Villela-G/educational_bench_for_angular_aero_control_of_multirotors/docs/documentation.md

---
layout: docs
title: Documentation
---

# Documentation

This section provides all the necessary information to reproduce and understand the platform.

The documentation follows a logical workflow from system design to final assembly.

---

## Structure

1. Hardware Design  
2. Electronics  
3. Bill of Materials  
4. Assembly  

---

## Navigation

Use the sidebar to access each section directly, or follow the sequence using the navigation below.

---

<div class="nav-next">
  <a href="hardware.html">Next: Hardware Design →</a>
</div>
