Villela-G/educational_bench_for_angular_aero_control_of_multirotors/docs/assets/images/bancada.jpeg

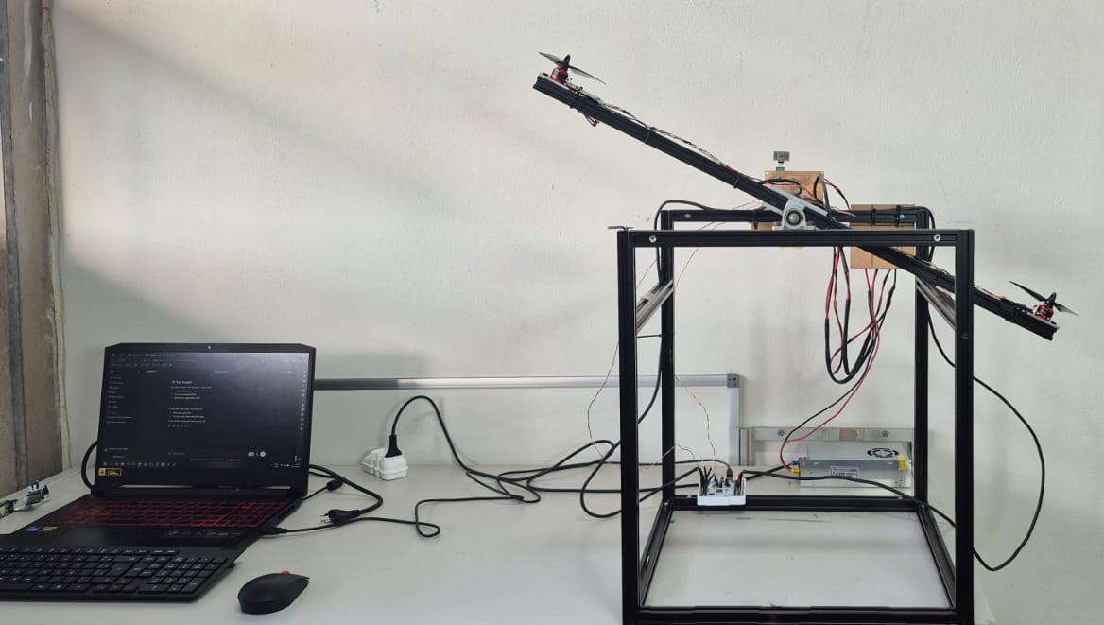
docs/assets/images/bancada.jpeg
