Villela-G/educational_bench_for_angular_aero_control_of_multirotors/docs/bom.md

---
layout: docs
title: Bill of Materials
---

# Bill of Materials

This section lists all components required to reproduce the platform, including mechanical, electronic, and structural elements.

---

## Components

<div style="overflow-x: auto; margin-top: 20px;">

<table>
<thead>
<tr>
<th>Designator</th>
<th>Component</th>
<th>Quantity</th>
<th>Material</th>
</tr>
</thead>

<tbody>

<tr><td>STM32</td><td>STM32F401RE board</td><td>1</td><td>Semiconductor</td></tr>
<tr><td>ESP32</td><td>ESP32 Wi-Fi module</td><td>1</td><td>Semiconductor</td></tr>
<tr><td>LM358</td><td>LM358 op-amp</td><td>2</td><td>Semiconductor</td></tr>
<tr><td>L7805</td><td>L7805 regulator</td><td>1</td><td>Semiconductor</td></tr>
<tr><td>L7808</td><td>L7808 regulator</td><td>1</td><td>Semiconductor</td></tr>

<tr><td>DRV5011</td><td>DRV5011 Hall sensor</td><td>4</td><td>Semiconductor</td></tr>
<tr><td>CurrentSensor</td><td>Current sensor</td><td>2</td><td>Semiconductor</td></tr>
<tr><td>DHT22</td><td>DHT22 sensor</td><td>1</td><td>Semiconductor</td></tr>
<tr><td>BMP280</td><td>BMP280 sensor</td><td>1</td><td>Semiconductor</td></tr>

<tr><td>C3300uF</td><td>3300 µF capacitor</td><td>1</td><td>Ceramic</td></tr>
<tr><td>C1uF</td><td>1 µF capacitor</td><td>2</td><td>Ceramic</td></tr>
<tr><td>C100nF</td><td>100 nF capacitor</td><td>4</td><td>Ceramic</td></tr>
<tr><td>C102nF</td><td>102 nF capacitor</td><td>2</td><td>Ceramic</td></tr>
<tr><td>C22nF</td><td>22 nF capacitor</td><td>5</td><td>Ceramic</td></tr>

<tr><td>R33k</td><td>33 kΩ resistor</td><td>2</td><td>Ceramic</td></tr>
<tr><td>R10k</td><td>10 kΩ resistor</td><td>3</td><td>Ceramic</td></tr>

<tr><td>KRE2V</td><td>KRE 2V connector</td><td>7</td><td>Metal</td></tr>
<tr><td>KRE3V</td><td>KRE 3V connector</td><td>3</td><td>Metal</td></tr>
<tr><td>KRV2V</td><td>KRV 2V connector</td><td>2</td><td>Metal</td></tr>

<tr><td>BananaBlackMale</td><td>Banana connector (black male)</td><td>1</td><td>Metal</td></tr>
<tr><td>BananaRedMale</td><td>Banana connector (red male)</td><td>1</td><td>Metal</td></tr>
<tr><td>BananaBlackFemale</td><td>Banana connector (black female)</td><td>1</td><td>Metal</td></tr>
<tr><td>BananaRedFemale</td><td>Banana connector (red female)</td><td>1</td><td>Metal</td></tr>

<tr><td>XT60Male</td><td>XT60 connector (male)</td><td>1</td><td>Polymer</td></tr>
<tr><td>XT60Female</td><td>XT60 connector (female)</td><td>1</td><td>Polymer</td></tr>

<tr><td>Motor2207</td><td>Brushless motor 2207 2388KV</td><td>1</td><td>Composite</td></tr>
<tr><td>ESC12A</td><td>BLHeli ESC 12A</td><td>1</td><td>Semiconductor</td></tr>
<tr><td>Prop5140</td><td>5140 propeller</td><td>1</td><td>Polymer</td></tr>

<tr><td>Profile500mm</td><td>Aluminum profile 20×20 (500 mm)</td><td>4</td><td>Metal</td></tr>
<tr><td>Profile400mm</td><td>Aluminum profile 20×20 (400 mm)</td><td>10</td><td>Metal</td></tr>

<tr><td>Shaft8mm</td><td>Stainless steel shaft (8 mm)</td><td>1</td><td>Metal</td></tr>
<tr><td>Bearing</td><td>Bearing KP08</td><td>1</td><td>Metal</td></tr>

<tr><td>MotorMounts</td><td>Motor mounts (custom)</td><td>2</td><td>Metal</td></tr>
<tr><td>PillowBlock</td><td>Pillow block (custom)</td><td>1</td><td>Metal</td></tr>

<tr><td>UniversalConnector20</td><td>Connector for 20 mm T-slot</td><td>16</td><td>Metal</td></tr>

<tr><td>M5x12</td><td>M5 × 12 mm screw</td><td>12</td><td>Metal</td></tr>
<tr><td>M5x14.5</td><td>M5 × 14.5 mm screw</td><td>4</td><td>Metal</td></tr>
<tr><td>M4x12</td><td>M4 × 12 mm screw</td><td>7</td><td>Metal</td></tr>
<tr><td>M3x10</td><td>M3 × 10 mm screw</td><td>4</td><td>Metal</td></tr>

<tr><td>HammerNutM5</td><td>M5 hammer nut</td><td>16</td><td>Metal</td></tr>

<tr><td>PrecisionPot</td><td>Precision potentiometer</td><td>1</td><td>Semiconductor</td></tr>
<tr><td>Potentiometer</td><td>Potentiometer</td><td>1</td><td>Semiconductor</td></tr>

<tr><td>Switch</td><td>Switch</td><td>1</td><td>Non-specific</td></tr>
<tr><td>KCD6</td><td>KCD6 switch</td><td>1</td><td>Non-specific</td></tr>

<tr><td>HeatSink</td><td>Heat sink</td><td>2</td><td>Metal</td></tr>

<tr><td>PCBBase</td><td>Phenolic board (100 × 100 mm)</td><td>4</td><td>Composite</td></tr>

</tbody>
</table>

</div>

---

<div style="display: flex; justify-content: space-between; margin-top: 60px;">
  <a href="electronics.html">← Previous: Electronics</a>
  <a href="assembly.html">Next: Assembly →</a>
</div>
