Villela-G/educational_bench_for_angular_aero_control_of_multirotors/docs/assembly.md

---
layout: docs
title: Assembly
---

# Assembly Instructions

## Pre-assembly Modifications

**Important:** The following modifications must be completed before assembly.

### Aluminum profiles
- Eight aluminum profiles (400 mm) must be drilled at both ends  
- Two holes per profile (one at each extremity)  
- Hole diameter: 6 mm  
- Maintain a consistent distance *x* from the ends for all profiles  

### Central pillow block
- All mounting holes must be threaded for M4 screws  

---

## Part 1 — Preparation of Aluminum Profiles

### Materials
- 8 × Aluminum profiles (400 mm)  
- 16 × Universal connectors  

### Procedure

1. Insert the connector nut into the T-slot  
   
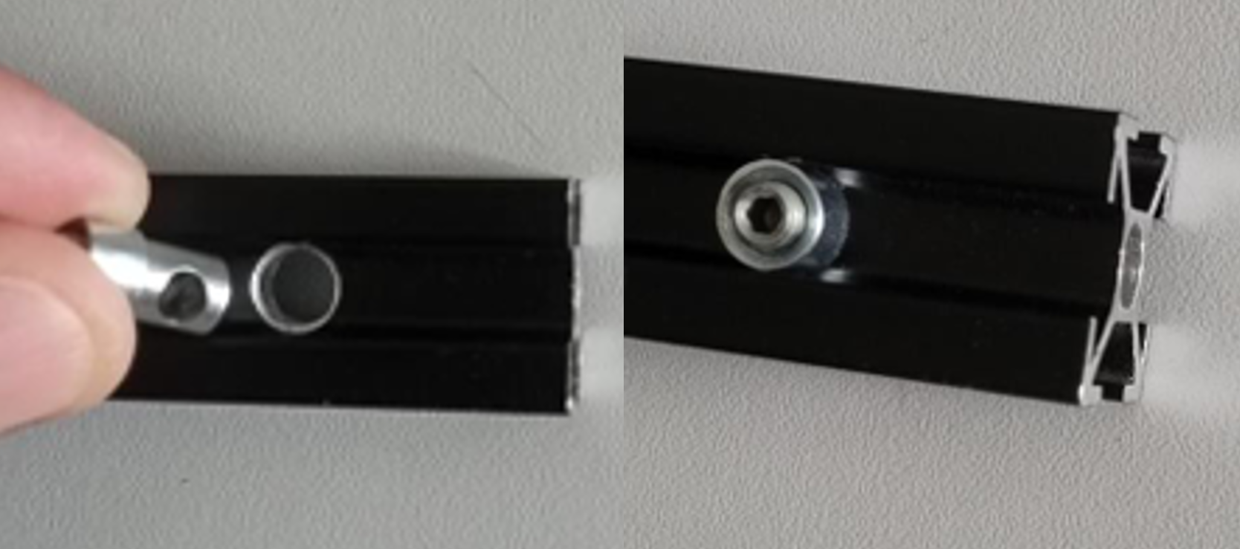
[picture p3: docs/assets/images/assembly/1.1.png]
   

2. Insert the connector screw, keeping it perpendicular  

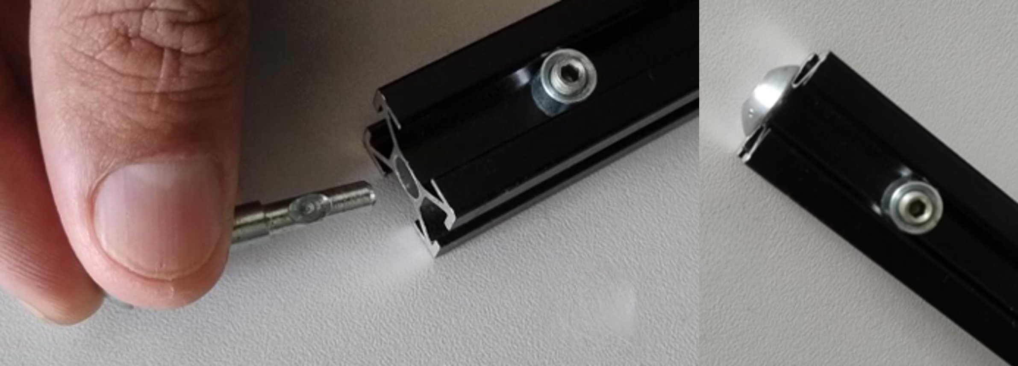
[picture p4: docs/assets/images/assembly/1.2.png]
   

3. Tighten using an Allen key  

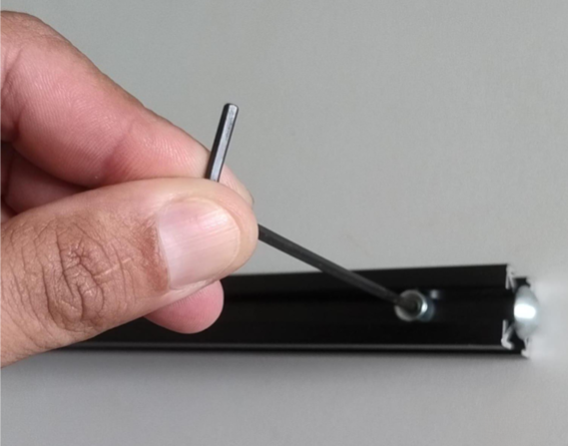
[picture p5: docs/assets/images/assembly/1.3.png]
   

4. Repeat for the opposite end and all profiles  

5. Final prepared profile:  

   

---

## Part 2 — Base Structure Assembly

### Materials
- 4 × Aluminum profiles (500 mm)  
- 8 × Aluminum profiles (400 mm)  

### Procedure

1. Arrange profiles perpendicularly  

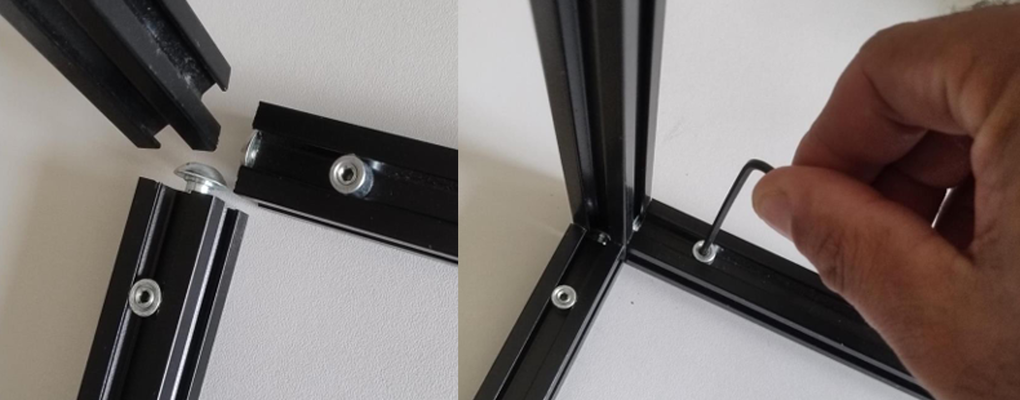
[picture p6: docs/assets/images/assembly/2.1.png]
   

2. Tighten all connections  

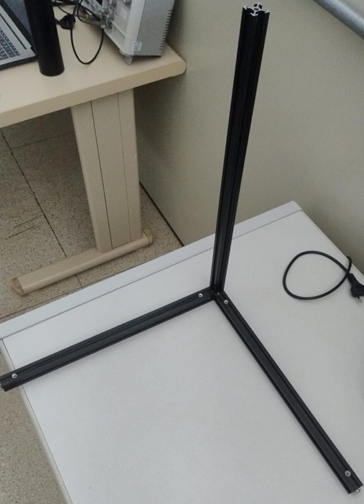
[picture p7: docs/assets/images/assembly/2.2.png]
   

3. Assemble two identical frames  

4. Join both frames into a rectangular base  

5. Fully tighten all fasteners  

   

6. Install upper profiles as end stops (~22.5 cm height)  

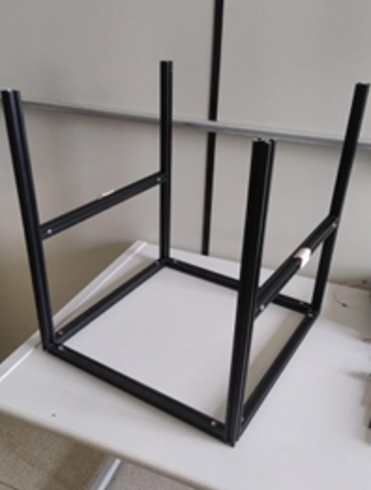
[picture p8: docs/assets/images/assembly/2.4.png]
   

7. Install shaft support profiles  

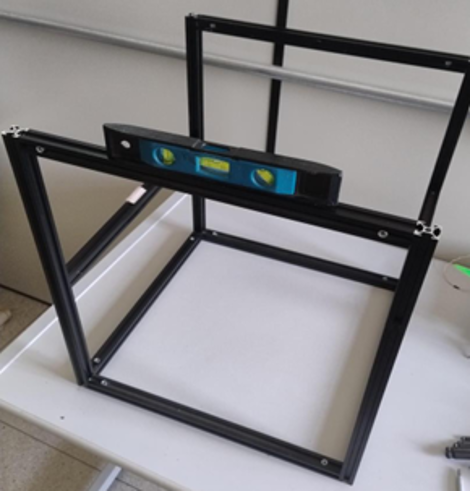
[picture p9: docs/assets/images/assembly/2.5.png]
   

8. Verify alignment and leveling  

   

---

## Part 3 — Rotational Axis and Actuation

### Materials
- 2 × Aluminum profiles (400 mm)  
- 1 × Steel shaft (8 mm × 450 mm)  
- 1 × Shaft coupler  
- 3 × Pillow block components  
- 2 × Bearing supports  
- 2 × Motor mounts  
- Fasteners (M3, M4, M5 + hammer nuts)  

### Procedure

1. Insert shaft into central pillow block  

2. Fix using M4 screws (2 top, 1 bottom)  

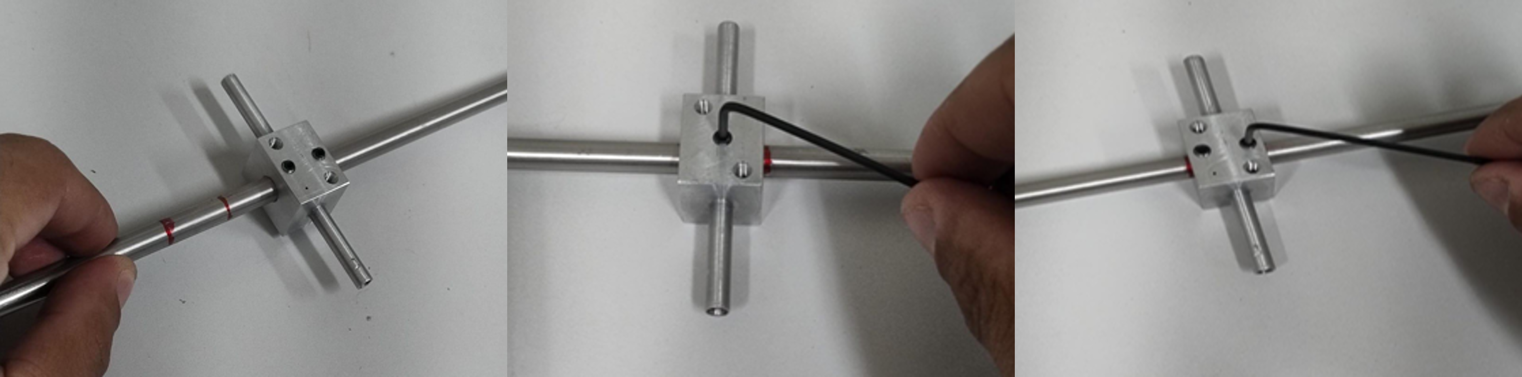
[picture p10: docs/assets/images/assembly/3.1.png]
   

3. Attach locking components  

     
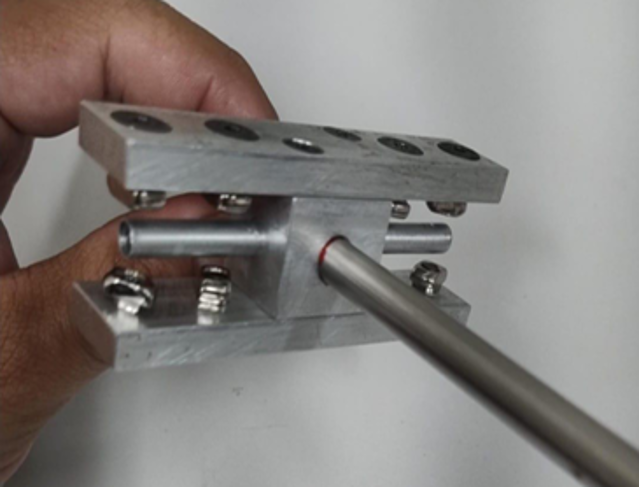
[picture p11: docs/assets/images/assembly/3.3.png]
   

4. Attach aluminum arms  

   

5. Install bearing supports and set spacing  

6. Attach shaft coupler  

   

7. Fix shaft assembly to structure  

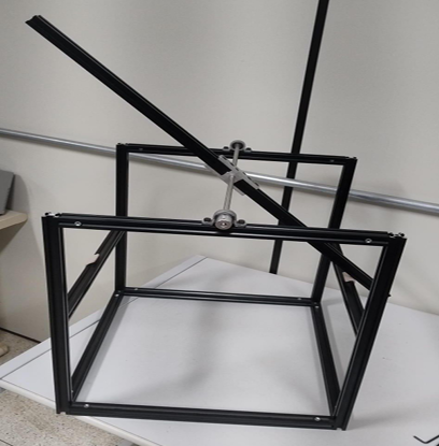
[picture p12: docs/assets/images/assembly/3.7.png]
   

8. Mount motors  

   

9. Attach motors to arms  

   

---

## Safety Notes

- Ensure all fasteners are fully tightened before operation  
- Verify structural alignment before powering the system  
- Keep clear of rotating propellers during testing  
- Use appropriate power supply and wiring insulation  

---

<div style="display: flex; justify-content: space-between; margin-top: 60px;">
  <a href="bom.html">← Previous: Bill of Materials</a>
</div>
