Villela-G/educational_bench_for_angular_aero_control_of_multirotors/docs/assets/images/assembly/3.5.png

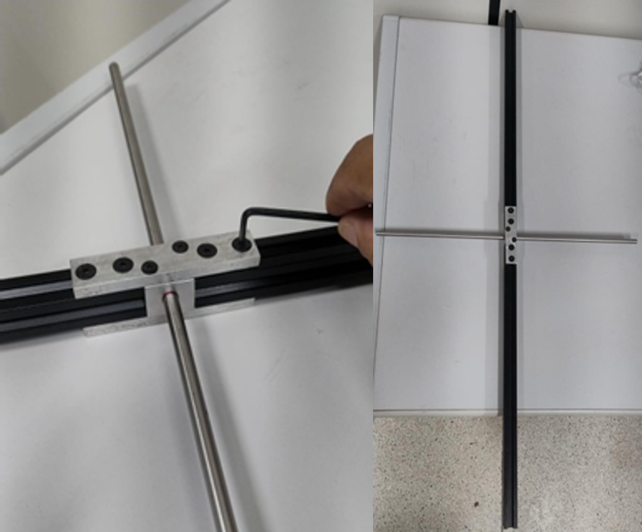
docs/assets/images/assembly/3.5.png
