Villela-G/educational_bench_for_angular_aero_control_of_multirotors/bancada_tcc_controle/Core/Src/main.c

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
/* Includes ------------------------------------------------------------------*/
#include "main.h"

/* USER CODE BEGIN Includes */
#include <stdio.h>
/* USER CODE END Includes */

/* USER CODE BEGIN PD */
#define MOTOR_RESET_CONDITION 0
#define MOTOR_IDLE_CONDITION 200
#define MOTOR_HOVER_CONDITION 1000//250
#define MOTOR_MAX_CONTROL 1800

#define KP 1.50f
#define KI 0.001f
#define KD 0.03f

#define IERR_MAX 1000.0f
#define IERR_MIN -1000.0f

#define D_FILTER_ALPHA 0.7f

//#define angle_inclination 0.619770239f
//#define angle_bias 1.187841465f

#define angle_inclination  18.15405//2.138189f
#define angle_bias 27.8726//5431.43f

#define STEP_LEFT_PWM 0
#define STEP_RIGHT_PWM_START 200U
#define STEP_RIGHT_PWM_INCREMENT 200U
#define STEP_RIGHT_PWM_LAST 1800U
#define STEP_SAMPLE_COUNT 1000U
#define STEP_COUNT (((STEP_RIGHT_PWM_LAST - STEP_RIGHT_PWM_START) / STEP_RIGHT_PWM_INCREMENT) + 1U)

/* USER CODE END PD */

ADC_HandleTypeDef hadc1;

TIM_HandleTypeDef htim2;
TIM_HandleTypeDef htim3;
TIM_HandleTypeDef htim4;

UART_HandleTypeDef huart2;
DMA_HandleTypeDef hdma_usart2_tx;

/* USER CODE BEGIN PV */
volatile uint8_t flag_user = 0;
uint8_t pData[2];

void HAL_GPIO_EXTI_Callback(uint16_t GPIO_Pin)
{
	if(GPIO_Pin == B1_Pin)
	{
		flag_user = 1;
	}
}

void blink_led(int repetitions)
{
	for(int i=0; i< repetitions; i++)
	{
	  HAL_GPIO_TogglePin(LD2_GPIO_Port, LD2_Pin);
	  HAL_Delay(20);
	}
}
void wait_user()
{
	while(!flag_user)
	{
		HAL_Delay(10);
	}
	flag_user = 0;
}

volatile uint8_t dataready = 0;
volatile uint32_t angle_in_bits = 0;
void HAL_ADC_ConvCpltCallback(ADC_HandleTypeDef* hadc)
{
    if(hadc->Instance == ADC1)
    {
        angle_in_bits = HAL_ADC_GetValue(hadc);
        dataready = 1U;
    }
}

uint32_t clip(int16_t action, uint16_t min, uint16_t max)
{
	if(action < min) action = min;
	if(action > max) action = max;
	return (uint32_t)action;
}


void PWM_setCombinedValue(TIM_HandleTypeDef* htim, int16_t left_actionx10, int16_t right_actionx10)
{//x20 não x10
	uint32_t norm_U_dir = clip(right_actionx10, 0, 2000);
	uint32_t norm_U_esq = clip(left_actionx10, 0, 2000);
	norm_U_dir = 2000+norm_U_dir;
	norm_U_esq = 2000+norm_U_esq;
	htim->Instance->CCR3 = norm_U_esq;
	htim->Instance->CCR1 = norm_U_dir;
	//__HAL_TIM_SET_COMPARE(&htim2, TIM_CHANNEL_1, norm_U_esq);
	//__HAL_TIM_SET_COMPARE(&htim2, TIM_CHANNEL_3, norm_U_dir);
}


/* USER CODE END PV */

void SystemClock_Config(void);
static void MX_GPIO_Init(void);
static void MX_DMA_Init(void);
static void MX_USART2_UART_Init(void);
static void MX_ADC1_Init(void);
static void MX_TIM2_Init(void);
static void MX_TIM3_Init(void);
static void MX_TIM4_Init(void);
/**
  * @brief  The application entry point.
  * @retval int
  */
int main(void)
{
  /* MCU Configuration--------------------------------------------------------*/

  /* Reset of all peripherals, Initializes the Flash interface and the Systick. */
  HAL_Init();

  /* Configure the system clock */
  SystemClock_Config();

  /* Initialize all configured peripherals */
  MX_GPIO_Init();
  MX_DMA_Init();
  MX_USART2_UART_Init();
  MX_ADC1_Init();
  MX_TIM2_Init();
  MX_TIM3_Init();
  MX_TIM4_Init();
  /* USER CODE BEGIN 2 */

//  HAL_UART_Transmit(&huart2, pData, 2, 1000);
 // HAL_UART_Transmit(&huart2, "\r\n", 2, 1000);
 //wait_user();
  HAL_TIM_PWM_Init(&htim2);
 // htim2.Instance->ARR = 39999;

  //Motor1 é esquerdo
  HAL_TIM_PWM_Start(&htim2, TIM_CHANNEL_1);
  HAL_TIM_PWM_Start(&htim2, TIM_CHANNEL_3);
  PWM_setCombinedValue(&htim2,0,0);
  HAL_Delay(1000);
  wait_user();
  /* USER CODE END 2 */

  /* Infinite loop */
  /* USER CODE BEGIN WHILE */
  PWM_setCombinedValue(&htim2,300,300);
  wait_user();
  HAL_ADC_Start_IT(&hadc1);
//  HAL_TIM_Encoder_Start(&htim3, TIM_CHANNEL_ALL);
  HAL_TIM_Encoder_Start(&htim4, TIM_CHANNEL_ALL);
  /* DEFINA AQUI AS PARTES DO CONTROLADOR - COMEÇO 1*/
  float angle, err, control, dErr = 0, Ierr=0, prevErr=0, prevEnc4=0, rpm=0;
  int32_t u_action;
  uint32_t md, me, sens_counter=0;
  uint32_t angle_bits_sample = 0;
  uint32_t current_step = 0;
  uint32_t step_idx = 0;
  uint16_t step_right_pwm = 0;
  uint8_t step_active = 0;
  char text[100];
  int msg_len;
  /* DEFINA AQUI AS PARTES DO CONTROLADOR - FIM 1 */
  while (1)
  {
    /* USER CODE END WHILE */

    /* USER CODE BEGIN 3 */
	  if(dataready)
	  {
	      __disable_irq();
	      angle_bits_sample = angle_in_bits;
	      dataready = 0U;
	      __enable_irq();

		  // =============================================
		  // Control Loop
		  // =============================================
	      sens_counter++;

	      /* --- Angle conversion --- */
	      float voltage = (angle_bits_sample * 3.3f) / 4095.0f;
	      angle = voltage * angle_inclination - angle_bias;

	      /* --- Error --- */
	      err = -angle;

	      /* --- Integral with anti-windup --- */
	      Ierr += err;
	      if(Ierr > IERR_MAX) Ierr = IERR_MAX;
	      if(Ierr < IERR_MIN) Ierr = IERR_MIN;

	      /* --- Derivative with filtering --- */
	      float raw_dErr = err - prevErr;
	      dErr = D_FILTER_ALPHA * dErr + (1.0f - D_FILTER_ALPHA) * raw_dErr;

	      prevErr = err;

	      /* --- PID control --- */
	      control = KP * err + KI * Ierr + KD * dErr;

	      /* --- Control scaling --- */
	      u_action = (int32_t)(control / 2.0f);

	      /* --- Motor mixing --- */
	      md = MOTOR_HOVER_CONDITION + u_action;
	      me = MOTOR_HOVER_CONDITION - u_action;

	      /* --- Saturation --- */
	      md = clip(md, MOTOR_IDLE_CONDITION, MOTOR_MAX_CONTROL);
	      me = clip(me, MOTOR_IDLE_CONDITION, MOTOR_MAX_CONTROL);


	      step_active = 0U;
	      current_step = 0U;
	      step_right_pwm = 0U;
	      for(step_idx = 0U; step_idx < STEP_COUNT; step_idx++)
	      {
	          if(sens_counter <= ((step_idx + 1U) * STEP_SAMPLE_COUNT))
	          {
	              current_step = step_idx + 1U;
	              step_right_pwm = (uint16_t)(STEP_RIGHT_PWM_START + (step_idx * STEP_RIGHT_PWM_INCREMENT));
	              step_active = 1U;
	              break;
	          }
	      }

	      if(step_active)
	      {
	          PWM_setCombinedValue(&htim2, STEP_LEFT_PWM, step_right_pwm);
	          HAL_GPIO_TogglePin(LD2_GPIO_Port, LD2_Pin);
	      }
	      else
	      {
	          PWM_setCombinedValue(&htim2, MOTOR_IDLE_CONDITION, MOTOR_IDLE_CONDITION);
	      }

		  // =============================================
		  // Sensors Log
		  // =============================================
//	      int16_t enc3 = __HAL_TIM_GET_COUNTER(&htim3);
	      int16_t enc4 = __HAL_TIM_GET_COUNTER(&htim4);
          if(abs(enc4) > 32000) // overflow
          {
            enc4=0;
          } 
	      rpm = (enc4 - prevEnc4)* 100 / 28 * 60; // \deltaEnc/(picos * \delta t) * (60 sec/min)
	      prevEnc4 = enc4;

	      if(step_active)
	      {
	          msg_len = snprintf(text, sizeof(text), "step=%lu,bits=%lu,rpm=%ld\r\n",
	                  (unsigned long)current_step, (unsigned long)angle_bits_sample, (long)rpm);
	          HAL_UART_Transmit(&huart2, (uint8_t*)text, (uint16_t)msg_len, 50);
	      }
	  }


	//HAL_UART_Transmit_DMA(&huart2, text, 50);


  }
  /* USER CODE END 3 */
}

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
