Villela-G/educational_bench_for_angular_aero_control_of_multirotors/bancada_tcc_controle/Core/Inc/main.h

#define B1_Pin GPIO_PIN_13
#define B1_GPIO_Port GPIOC
#define B1_EXTI_IRQn EXTI15_10_IRQn
#define sensor_Pin GPIO_PIN_1
#define sensor_GPIO_Port GPIOA
#define USART_TX_Pin GPIO_PIN_2
#define USART_TX_GPIO_Port GPIOA
#define USART_RX_Pin GPIO_PIN_3
#define USART_RX_GPIO_Port GPIOA
#define LD2_Pin GPIO_PIN_5
#define LD2_GPIO_Port GPIOA
#define TMS_Pin GPIO_PIN_13
#define TMS_GPIO_Port GPIOA
#define TCK_Pin GPIO_PIN_14
#define TCK_GPIO_Port GPIOA
#define SWO_Pin GPIO_PIN_3
#define SWO_GPIO_Port GPIOB
#define halle1_Pin GPIO_PIN_4
#define halle1_GPIO_Port GPIOB
#define halle2_Pin GPIO_PIN_5
#define halle2_GPIO_Port GPIOB
#define halld2_Pin GPIO_PIN_6
#define halld2_GPIO_Port GPIOB
#define halld1_Pin GPIO_PIN_7
#define halld1_GPIO_Port GPIOB
