Villela-G/educational_bench_for_angular_aero_control_of_multirotors/sensor_tests/dht22/dht22/dht22.ino

/*
 * You can find the DHT Library from Arduino official website
 * https://playground.arduino.cc/Main/DHTLib
 */
 
#include <dht.h>

#define dataPin 8 // Defines pin number to which the sensor is connected
dht DHT; // Creats a DHT object

void setup() {
  Serial.begin(9600);
}
void loop() {
  int readData = DHT.read22(dataPin); // Reads the data from the sensor
  float t = DHT.temperature; // Gets the values of the temperature
  float h = DHT.humidity; // Gets the values of the humidity
  
  // Printing the results on the serial monitor
  Serial.print("Temperature = ");
  Serial.print(t);
  Serial.print(" *C ");
  Serial.print("    Humidity = ");
  Serial.print(h);
  Serial.println(" % ");
  
  delay(2000); // Delays 2 secods, as the DHT22 sampling rate is 0.5Hz
}
