Villela-G/educational_bench_for_angular_aero_control_of_multirotors/(commit log)

2026-03-23 Add full documentation site (layouts, assets, assembly, electronics, BOM, hardware)
2026-03-23 Add sensor validation codes with structured README
