Villela-G/educational_bench_for_angular_aero_control_of_multirotors/(notices)

Notices in the files:
bancada_tcc_controle/Core/Src/main.c:
Copyright (c) 2023 STMicroelectronics.
All rights reserved.
This software is licensed under terms that can be found in the LICENSE file
bancada_tcc_controle/Core/Inc/main.h:
Copyright (c) 2026 STMicroelectronics.
